gabrielcessil/ModularSoundMixer/Figures/Test_ConfigUnplug.png

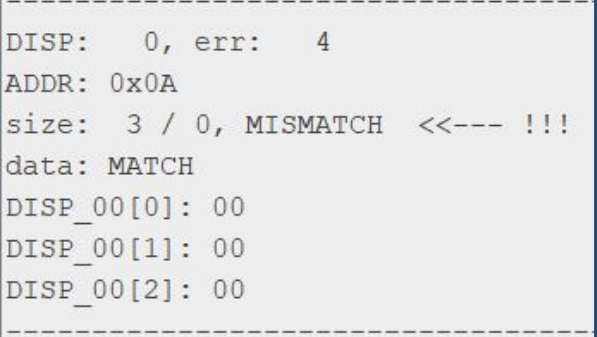
Figures/Test_ConfigUnplug.png
