gabrielcessil/ModularSoundMixer/VolumeController.py

from numpy import double
import pulsectl

# Atua sobre as fontes de audio
class Mixer:
    def __init__(self, name="User"):
        self.pulse = pulsectl.Pulse(name)
        self.Cabecalhos = {"Iddle": 0, "Fonte": 1, "Geral": 2}
        self.NumeroMixers = 0

    def __del__(self):
        self.pulse.close()

    def GetFontePorNome(self, nome):
        sink_inputs = self.pulse.sink_input_list()
        Fontes = []
        for sink in sink_inputs:
            if sink.proplist["application.name"] == nome:
                Fontes.append(sink)
        return Fontes

    def GetVolume(self, appName):
        # Volume das fontes de mesmo app deveriam ser as mesmas
        fontes = self.GetFontePorNome(appName)
        if fontes:
            return fontes[0].volume.value_flat
        else:
            return 0

    # Retorna nome das aplicacoes emitindo som
    def GetNomeFontes(self):
        NomeFontes = []
        sink_inputs = self.pulse.sink_input_list()
        if sink_inputs:
            for sink in sink_inputs:
                nome = sink.proplist["application.name"]
                try:
                    i = NomeFontes.index(nome)
                except:
                    NomeFontes.append(nome)
        return NomeFontes

    def getVolumeFonte(self, fonte):
        return fonte.volume.value_flat

    def VerificaNovoVolume(self, vol):
        if vol >= 1.2:
            return 1.2
        elif vol <= 0:
            return 0
        else:
            return vol

    def MudaVolumeFonte(self, volumeLevel_percent, fonte):

        try:
            newVol = self.VerificaNovoVolume(volumeLevel_percent)
            new_volume = pulsectl.PulseVolumeInfo(newVol, len(fonte.volume.values))
            self.pulse.volume_set(fonte, new_volume)
        except:
            print("Erro ao mudar volume PulseAudio")

    def MuteAll(self):
        for fonte in self.pulse.sink_list():
            newVol = 0
            self.MudaVolumeFonte(volumeLevel_percent=newVol, fonte=fonte)

    def MuteFonte(self, fonte):
        if fonte:
            newVol = 0
            self.MudaVolumeFonte(volumeLevel_percent=newVol, fonte=fonte)

    def MudaVolumeGeral(self, volume_percent):
        for fonte in self.pulse.sink_list():
            newVol = volume_percent
            self.MudaVolumeFonte(volumeLevel_percent=newVol, fonte=fonte)

    def EhFonteValida(self, fonteIndex):
        if fonteIndex < 0:
            return False
        else:
            sink_inputs = self.pulse.sink_input_list()
            nFontes = len(sink_inputs)
            if fonteIndex >= nFontes:
                return False
            else:
                return True

    def OperaComandos(self, SinaisInterpretados):

        for [cabecalho, fontes, volume_percent] in SinaisInterpretados:
            if cabecalho == self.Cabecalhos["Fonte"]:
                for fonte in fontes:
                    self.MudaVolumeFonte(volume_percent, fonte)

            elif cabecalho == self.Cabecalhos["Geral"]:
                self.MudaVolumeGeral(volume_percent)
