gabrielcessil/ModularSoundMixer/(commit log)

2025-02-05 Current state of work
2025-02-05 Arduino testing scripts
